DIY-Nabra/DuberEuro-DIY/assets/alt-panel.png

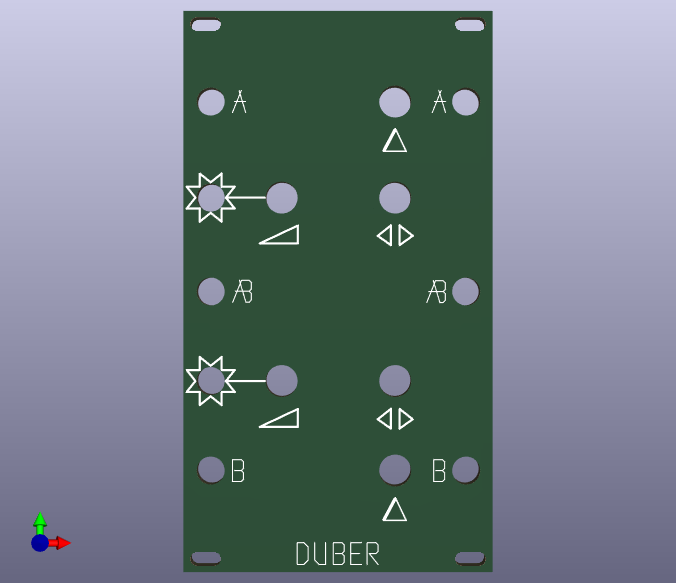
assets/alt-panel.png
