DIY-Nabra/DuberEuro-DIY/assets/mainboard_front.png

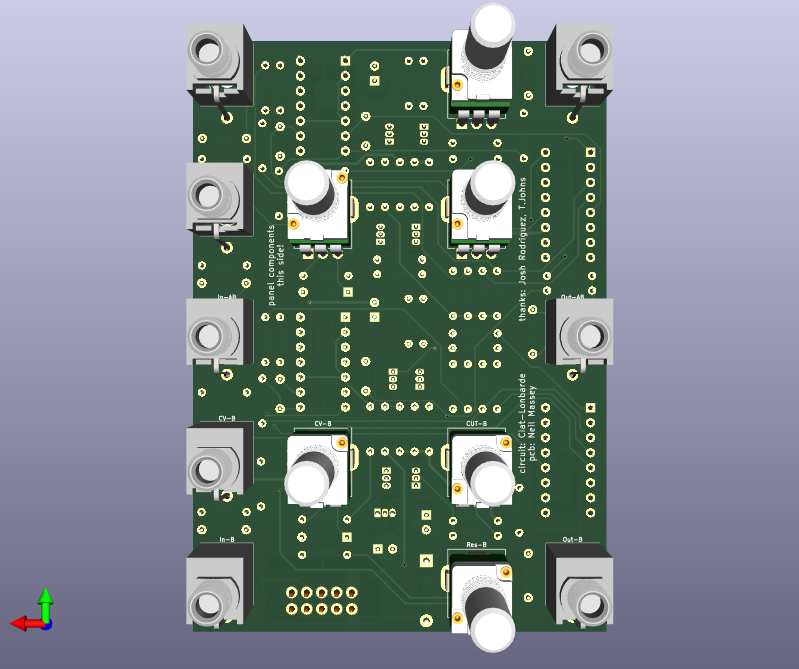
assets/mainboard_front.png
