DIY-Nabra/DuberEuro-DIY/duberBOM.md

# Duber Bill of Materials (BOM)

To build just follow the order in the BOM.

When soldering the ICs (U2->U5), solder in the equivalent sockets instead.

Solder the panel components (jacks and pots) last, on the opposite side of the board to the other parts.

| Reference | Quantity | Part | Notes |
|---|---|---|---|
| R24,R25,R40,R41,R46,R47,R48,R49 | 8 | 10k | |
| R22,R23 | 2 | 100k | |
| R8,R30 | 2 | 1M | |
| R31,R32,R44,R45 | 4 | 22k | |
| R1,R2,R15,R26,R27,R43 | 6 | 220k | |
| R18,R19,R20,R21,R35,R36,R37,R38| 8 | 470R | |
| R3,R4,R11,R12,R28,R29,R39,R42 | 8 | 4.7k | |
| R5,R6,R7,R9,R10,R13,R14,R16,R17,R33,R34,R50 | 12 | 47k | |
| D1,D3 | 2 | BAT85 | Negative voltage protection diodes |
| D2 | 1 | 1N4001 | Reverse voltage protection diode |
| C1,C2,C3,C12,C13,C14 | 6 | 100nF | Mylar or MLCC, audio path |
| C4,C5,C6,C9 | 4 | 10uF Electrolytic | Power conditioning caps |
| C10,C8,C11,C7 | 4 | 1nF | Mylar or MLCC |
| Q2,Q3,Q4,Q6,Q7,Q8 | 6 | BC557 | |
| Q1,Q5 | 2 | BC547 | TO92 |
| U1 | 1 | L78L09 TO92 | Power regulator |
| U2,U3 | 2 | TL084 | Or use TL074 |
| U4,U5 | 2 | LM13700 | |
| J5 | 1 | Eurorack 2x5 shrouded male | |
| RV1,RV2,RV3,RV4,RV5,RV6 | 6 | 10k 9mm potentiometer | |
| J1,J2,J3,J4,J6,J7,J8,J9 | 8 | Thonkiconn 3.5mm mono socket | |
| IC socket 14 pin | 2 | DIP 14 pin socket | |
| IC socket 16 pin | 2 | DIP 16 pin socket | |
