DIY-Nabra/DuberEuro-DIY/assets/mainboard_back.png

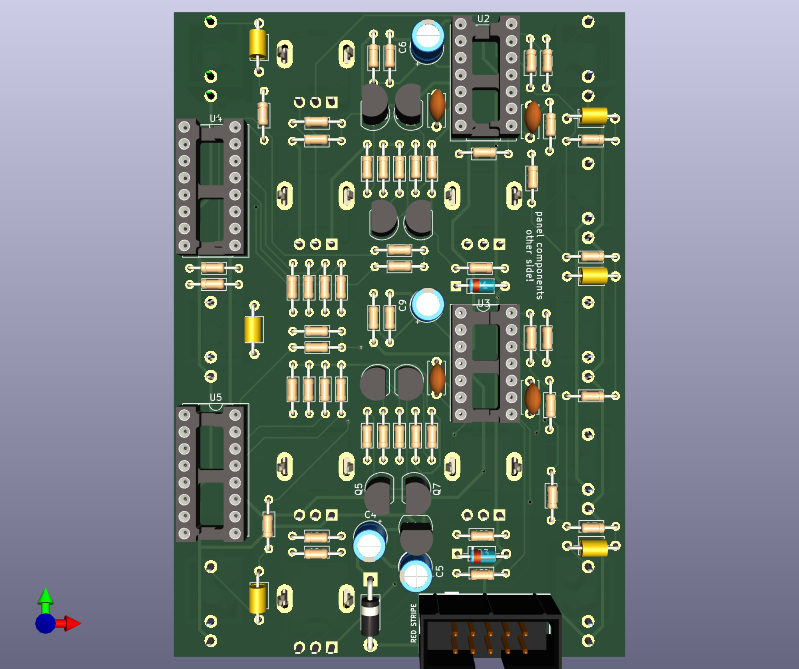
assets/mainboard_back.png
