DIY-Nabra/DuberEuro-DIY/LTSpice/duber.asc

C1: cap; 100nF
C2: polcap; 1µF
C3: cap; 1nF
C4: cap; 1nF
C5: cap; 100nF
Q1: npn; BC547C
Q2: pnp; BC557C
Q3: pnp; BC557C
Q4: pnp; BC557C
R1: res; 47k
R2: res; 22k
R3: res; 22k
R4: res; 47k
R5: res; 47k
R6: res; 470
R7: res; 470
R8: res; 47k
R9: res; 470
R10: res; 470
R11: res; 100k
R12: res; 5k
R13: res; 5k
R14: res; 47k
R15: res; 220k
R16: res; 4.7k
R17: res; 4.7k
R18: res; 10k
R19: res; 10k
R20: res; 220k
R22: res; 4.7k
R23: res; 1Meg
R24: res; 4.7k
R25: res; 220k
U1: opamp2; TL072
U2: UniversalOpamp
U3: LM13700
U4: opamp2; TL072
U5: LM13700
U6: opamp2; TL072
V1: voltage; 9
V2: voltage; PULSE(0 9 0 0.0000001 0.0000001 0.0005 0.0010)
V3: voltage; 5
V4: voltage; 4.5
V5: voltage; 0
Named nets: 9V, 0, Sig, MIDO, CVC, CUT, OUT, CV
.lib lm13700.sub
.lib tl072ti.lib
.tran 0.05
