DIY-Nabra/DuberEuro-DIY/mainboard/mainboard.kicad_pcb

## KiCad design mainboard/mainboard.kicad_pcb (2022-08-26)

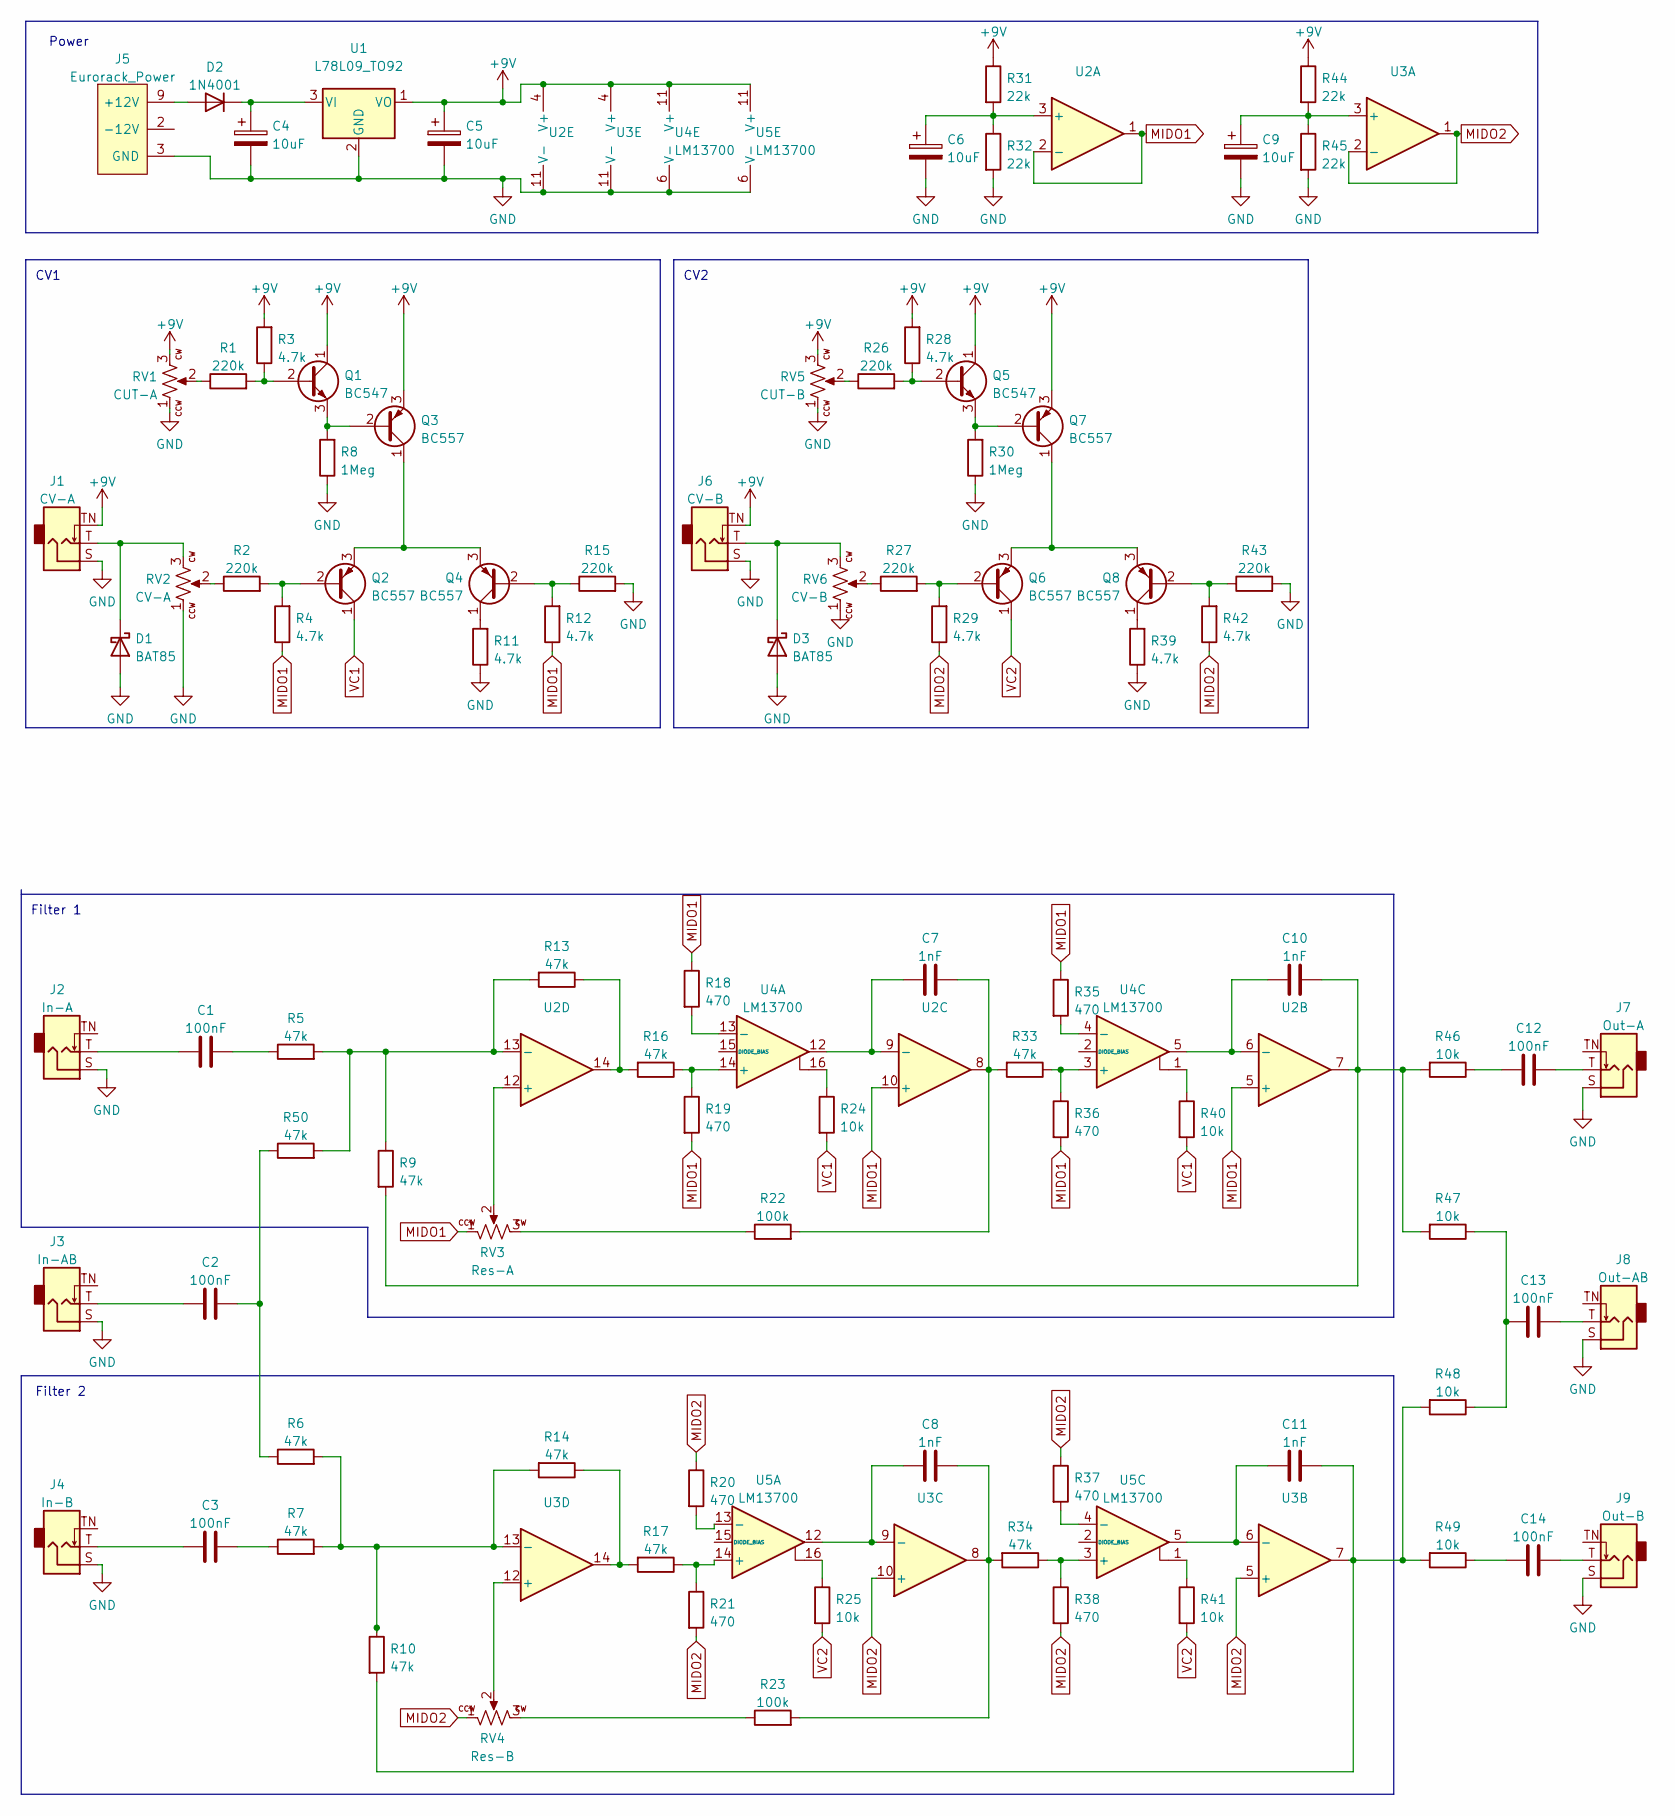
[picture p5: schematic mainboard.kicad_sch, Duber Filter]

Parts:
C1, C2, C3, C12, C13, C14: 100nF; C_Axial_L3.8mm_D2.6mm_P7.50mm_Horizontal
C4, C5, C6, C9: 10uF; CP_Radial_D5.0mm_P2.50mm
C7, C8, C10, C11: 1nF; C_Disc_D5.0mm_W2.5mm_P5.00mm
D1, D3: BAT85; D_DO-35_SOD27_P7.62mm_Horizontal
D2: 1N4001; D_DO-41_SOD81_P10.16mm_Horizontal
J1: CV-A; AudioJack_WQP518MA; MPN WQP-WQP518MA
J2: In-A; AudioJack_WQP518MA; MPN WQP-WQP518MA
J3: In-AB; AudioJack_WQP518MA; MPN WQP-WQP518MA
J4: In-B; AudioJack_WQP518MA; MPN WQP-WQP518MA
J5: Eurorack_Power; Eurorack_Power_2x5_Shrouded; MPN 302-S101
J6: CV-B; AudioJack_WQP518MA; MPN WQP-WQP518MA
J7: Out-A; AudioJack_WQP518MA; MPN WQP-WQP518MA
J8: Out-AB; AudioJack_WQP518MA; MPN WQP-WQP518MA
J9: Out-B; AudioJack_WQP518MA; MPN WQP-WQP518MA
Q1, Q5: BC547; TO-92_Inline
Q2, Q3, Q4, Q6, Q7, Q8: BC557; TO-92_Inline
R1, R2, R15, R26, R27, R43: 220k; R_Axial_DIN0204_L3.6mm_D1.6mm_P7.62mm_Horizontal
R3, R4, R11, R12, R28, R29, R39, R42: 4.7k; R_Axial_DIN0204_L3.6mm_D1.6mm_P7.62mm_Horizontal
R5, R6, R7, R9, R10, R13, R14, R16, R17, R33, R34, R50: 47k; R_Axial_DIN0204_L3.6mm_D1.6mm_P7.62mm_Horizontal
R8, R30: 1Meg; R_Axial_DIN0204_L3.6mm_D1.6mm_P7.62mm_Horizontal
R18, R19, R20, R21, R35, R36, R37, R38: 470; R_Axial_DIN0204_L3.6mm_D1.6mm_P7.62mm_Horizontal
R22, R23: 100k; R_Axial_DIN0204_L3.6mm_D1.6mm_P7.62mm_Horizontal
R24, R25, R40, R41, R46, R47, R48, R49: 10k; R_Axial_DIN0204_L3.6mm_D1.6mm_P7.62mm_Horizontal
R31, R32, R44, R45: 22k; R_Axial_DIN0204_L3.6mm_D1.6mm_P7.62mm_Horizontal
RV1: CUT-A; Potentiometer_Alpha_R0904N; MPN R0904N-???? L-25KQ/LWS
RV2: CV-A; Potentiometer_Alpha_R0904N; MPN R0904N-???? L-25KQ/LWS
RV3: Res-A; Potentiometer_Alpha_R0904N; MPN R0904N-???? L-25KQ/LWS
RV4: Res-B; Potentiometer_Alpha_R0904N; MPN R0904N-???? L-25KQ/LWS
RV5: CUT-B; Potentiometer_Alpha_R0904N; MPN R0904N-???? L-25KQ/LWS
RV6: CV-B; Potentiometer_Alpha_R0904N; MPN R0904N-???? L-25KQ/LWS
U1: L78L09_TO92; TO-92_Inline
U2, U3: (no value)
U4, U5: LM13700; DIP-16_W7.62mm_Socket

Connections:
+9V: C5.1, J1.TN (Tip_normalize), J6.TN (Tip_normalize), Q1.1 (C), Q3.3 (E), Q5.1 (C), Q7.3 (E), R3.2, R28.2, R31.1, R44.1, RV1.3, RV5.3, U1.1 (VO), U2.4 (V+), U3.4 (V+), U4.11 (V+), U5.11 (V+)
GND: C4.2, C5.2, C6.2, C9.2, D1.2 (A), D3.2 (A), J1.S (Sleeve), J2.S (Sleeve), J3.S (Sleeve), J4.S (Sleeve), J5.3 (GND), J5.4 (GND), J5.5 (GND), J5.6 (GND), J5.7 (GND), J5.8 (GND), J6.S (Sleeve), J7.S (Sleeve), J8.S (Sleeve), J9.S (Sleeve), R8.1, R11.1, R15.2, R30.1, R32.2, R39.1, R43.2, R45.2, RV1.1, RV2.1, RV5.1, RV6.1, U1.2 (GND), U2.11 (V-), U3.11 (V-), U4.6 (V-), U5.6 (V-)
MIDO1: R4.1, R12.1, R18.1, R19.2, R35.1, R36.2, RV3.1, U2.1, U2.2 (-), U2.5 (+), U2.10 (+)
MIDO2: R20.1, R21.2, R29.1, R37.1, R38.2, R42.1, RV4.1, U3.1, U3.2 (-), U3.5 (+), U3.10 (+)
unnamed: C1.1, J2.T (Tip)
unnamed: C1.2, R5.1
unnamed: C2.1, J3.T (Tip)
unnamed: C2.2, R6.1, R50.1
unnamed: C3.1, J4.T (Tip)
unnamed: C3.2, R7.1
unnamed: C4.1, D2.1 (K), U1.3 (VI)
unnamed: C6.1, R31.2, R32.1, U2.3 (+)
unnamed: C7.1, U2.9 (-), U4.12
unnamed: C7.2, R22.2, R33.2, U2.8
unnamed: C8.1, U3.9 (-), U5.12
unnamed: C8.2, R23.2, R34.2, U3.8
unnamed: C9.1, R44.2, R45.1, U3.3 (+)
unnamed: C10.1, U2.6 (-), U4.5
unnamed: C10.2, R9.2, R46.2, R47.2, U2.7
unnamed: C11.1, U3.6 (-), U5.5
unnamed: C11.2, R10.2, R48.2, R49.2, U3.7
unnamed: C12.1, R46.1
unnamed: C12.2, J7.T (Tip)
unnamed: C13.1, R47.1, R48.1
unnamed: C13.2, J8.T (Tip)
unnamed: C14.1, R49.1
unnamed: C14.2, J9.T (Tip)
unnamed: D1.1 (K), J1.T (Tip), RV2.3
unnamed: D2.2 (A), J5.9 (+12V), J5.10 (+12V)
unnamed: D3.1 (K), J6.T (Tip), RV6.3
unnamed: J5.1 (-12V), J5.2 (-12V)
unnamed: Q1.2 (B), R1.2, R3.1
unnamed: Q1.3 (E), Q3.2 (B), R8.2
unnamed: Q2.2 (B), R2.2, R4.2
unnamed: Q2.3 (E), Q3.1 (C), Q4.3 (E)
unnamed: Q4.1 (C), R11.2
unnamed: Q4.2 (B), R12.2, R15.1
unnamed: Q5.2 (B), R26.2, R28.1
unnamed: Q5.3 (E), Q7.2 (B), R30.2
unnamed: Q6.2 (B), R27.2, R29.2
unnamed: Q6.3 (E), Q7.1 (C), Q8.3 (E)
unnamed: Q8.1 (C), R39.2
unnamed: Q8.2 (B), R42.2, R43.1
unnamed: R1.1, RV1.2
unnamed: R2.1, RV2.2
unnamed: R6.2, R7.2, R10.1, R14.2, U3.13 (-)
unnamed: R13.1, R16.2, U2.14
unnamed: R5.2, R9.1, R13.2, R50.2, U2.13 (-)
unnamed: R14.1, R17.2, U3.14
unnamed: R16.1, R19.1, U4.14 (+)
unnamed: R17.1, R21.1, U5.14 (+)
unnamed: R18.2, U4.13 (-)
unnamed: R20.2, U5.13 (-)
unnamed: R22.1, RV3.3
unnamed: R23.1, RV4.3
unnamed: R24.1, U4.16
unnamed: R25.1, U5.16
unnamed: R26.1, RV5.2
unnamed: R27.1, RV6.2
unnamed: R33.1, R36.1, U4.3 (+)
unnamed: R34.1, R38.1, U5.3 (+)
unnamed: R35.2, U4.4 (-)
unnamed: R37.2, U5.4 (-)
unnamed: R40.1, U4.1
unnamed: R41.1, U5.1
unnamed: RV3.2, U2.12 (+)
unnamed: RV4.2, U3.12 (+)
VC1: Q2.1 (C), R24.2, R40.2
VC2: Q6.1 (C), R25.2, R41.2

Notes on the sheet:
CV1
Filter 2
Power
Filter 1
CV2

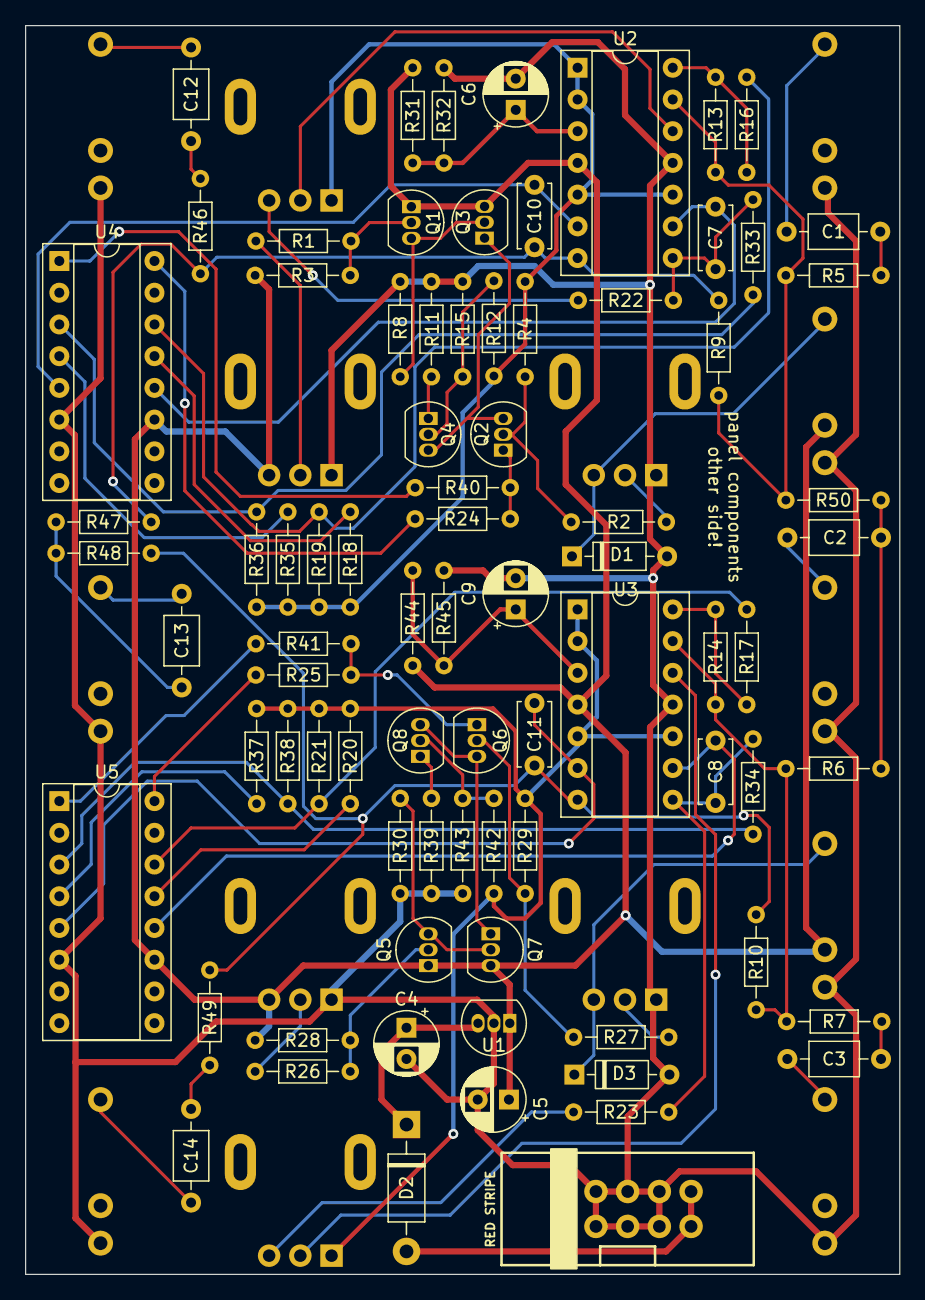
[picture p6: board mainboard.kicad_pcb from above]

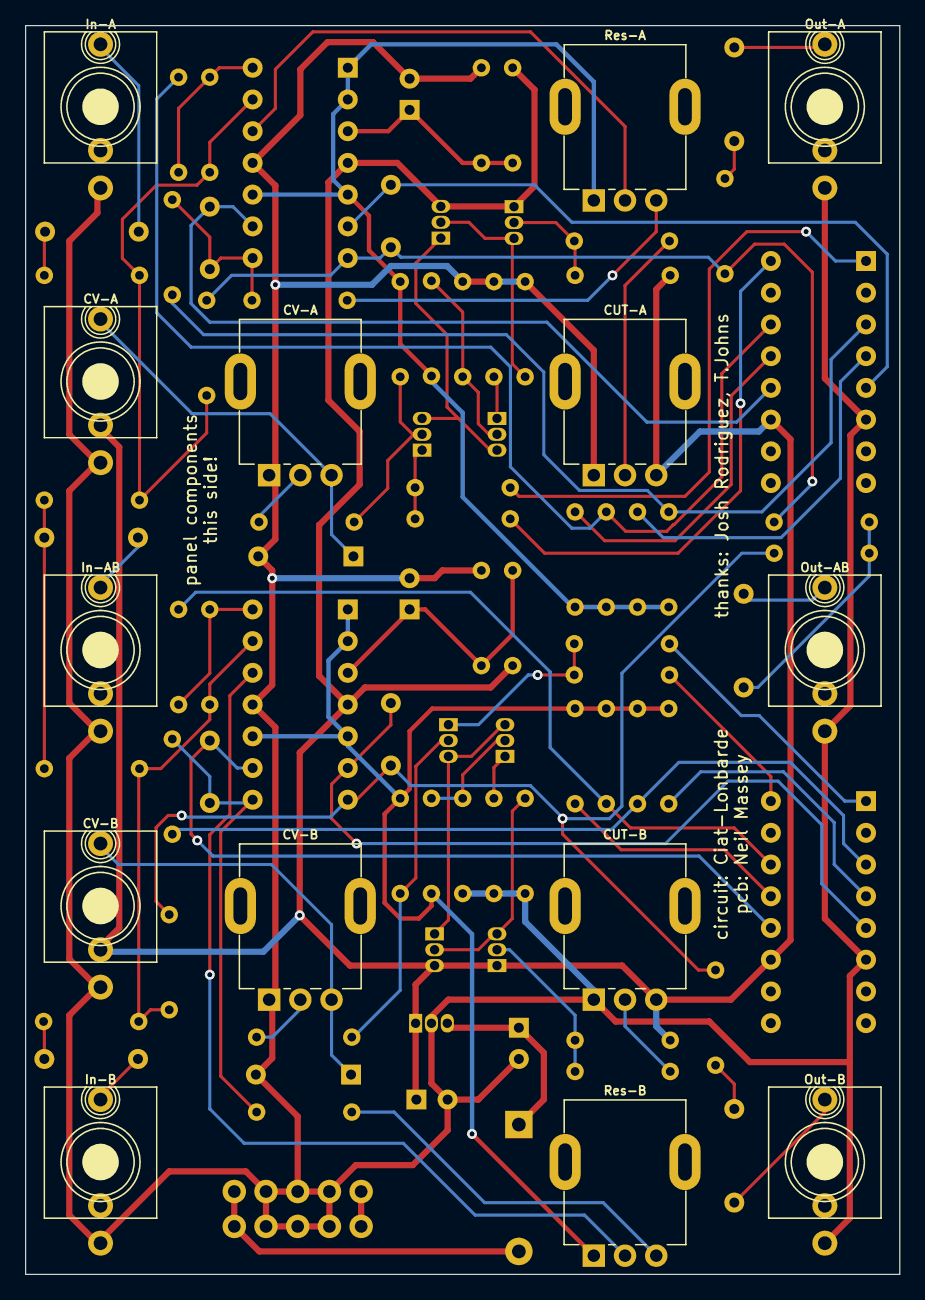
[picture p7: board mainboard.kicad_pcb from below]

Board: 2 copper layers, 70.0 x 100.0 mm, 95 parts (14 on the bottom side), 69 nets.
