DIY-Nabra/DuberEuro-DIY/(commit log)

2022-08-03 First commit of KiCad implementation of Vaux Flores interpretation of the Duber filter
    [mainboard.kicad_pcb, mainboard.kicad_sch]
2022-08-25 Panel and trace corrections
    [alt-panel.kicad_pcb, mainboard-User_2.dxf, mainboard.kicad_pcb, mainboard.kicad_sch]
2022-08-25 added mainboard.kicad_prl
2022-08-26 Panel tweak
    [alt-panel.kicad_pcb]
2022-08-26 Panel tweaks
    [alt-panel.kicad_pcb, mainboard-User_2.dxf, mainboard.kicad_pcb]
2022-08-26 Added BOM
